pierrejay/sonnette-sip-doorbell/pics/README.md

# pics

Illustrative pictures used by the README and hardware guide.

These files are documentation visuals only. In particular, the enclosure
renders show a 3D-printed prototype, but the enclosure CAD sources are not
published in this repository.
