pierrejay/sonnette-sip-doorbell/docs/README.md

# docs

Project guides and runbooks.

Read them in this order:

1. [twilio.md](twilio.md) — Twilio account, number, SIP Domain and TwiML.
2. [hardware.md](hardware.md) — Linux image, BSP, flashing and hardware notes.
3. [deploy.md](deploy.md) — Build, deploy, harden and verify the application.

The top-level [README](../README.md) gives the short project overview.
