pierrejay/sonnette-sip-doorbell/pics/doorbell_3d_cad_1.png

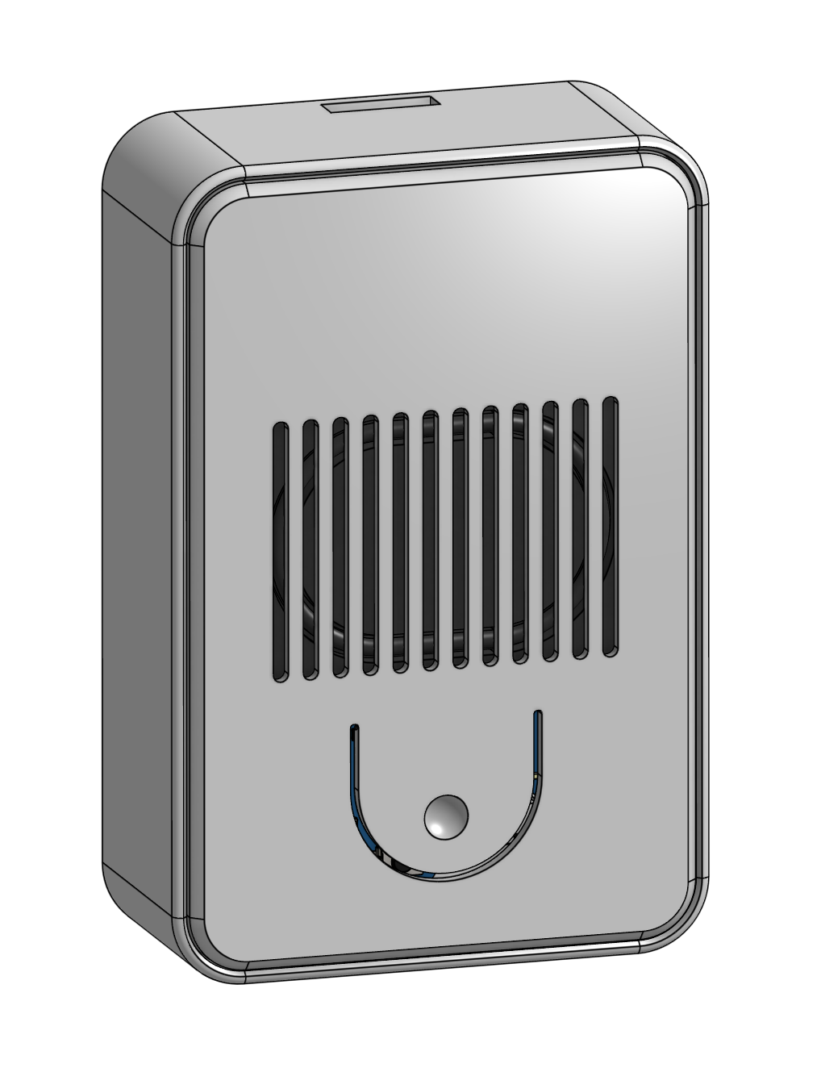
pics/doorbell_3d_cad_1.png
