pierrejay/sonnette-sip-doorbell/eda/sonnette_sch.pdf

# Debug UART

# PMIC (new, replaces discrete bucks below)

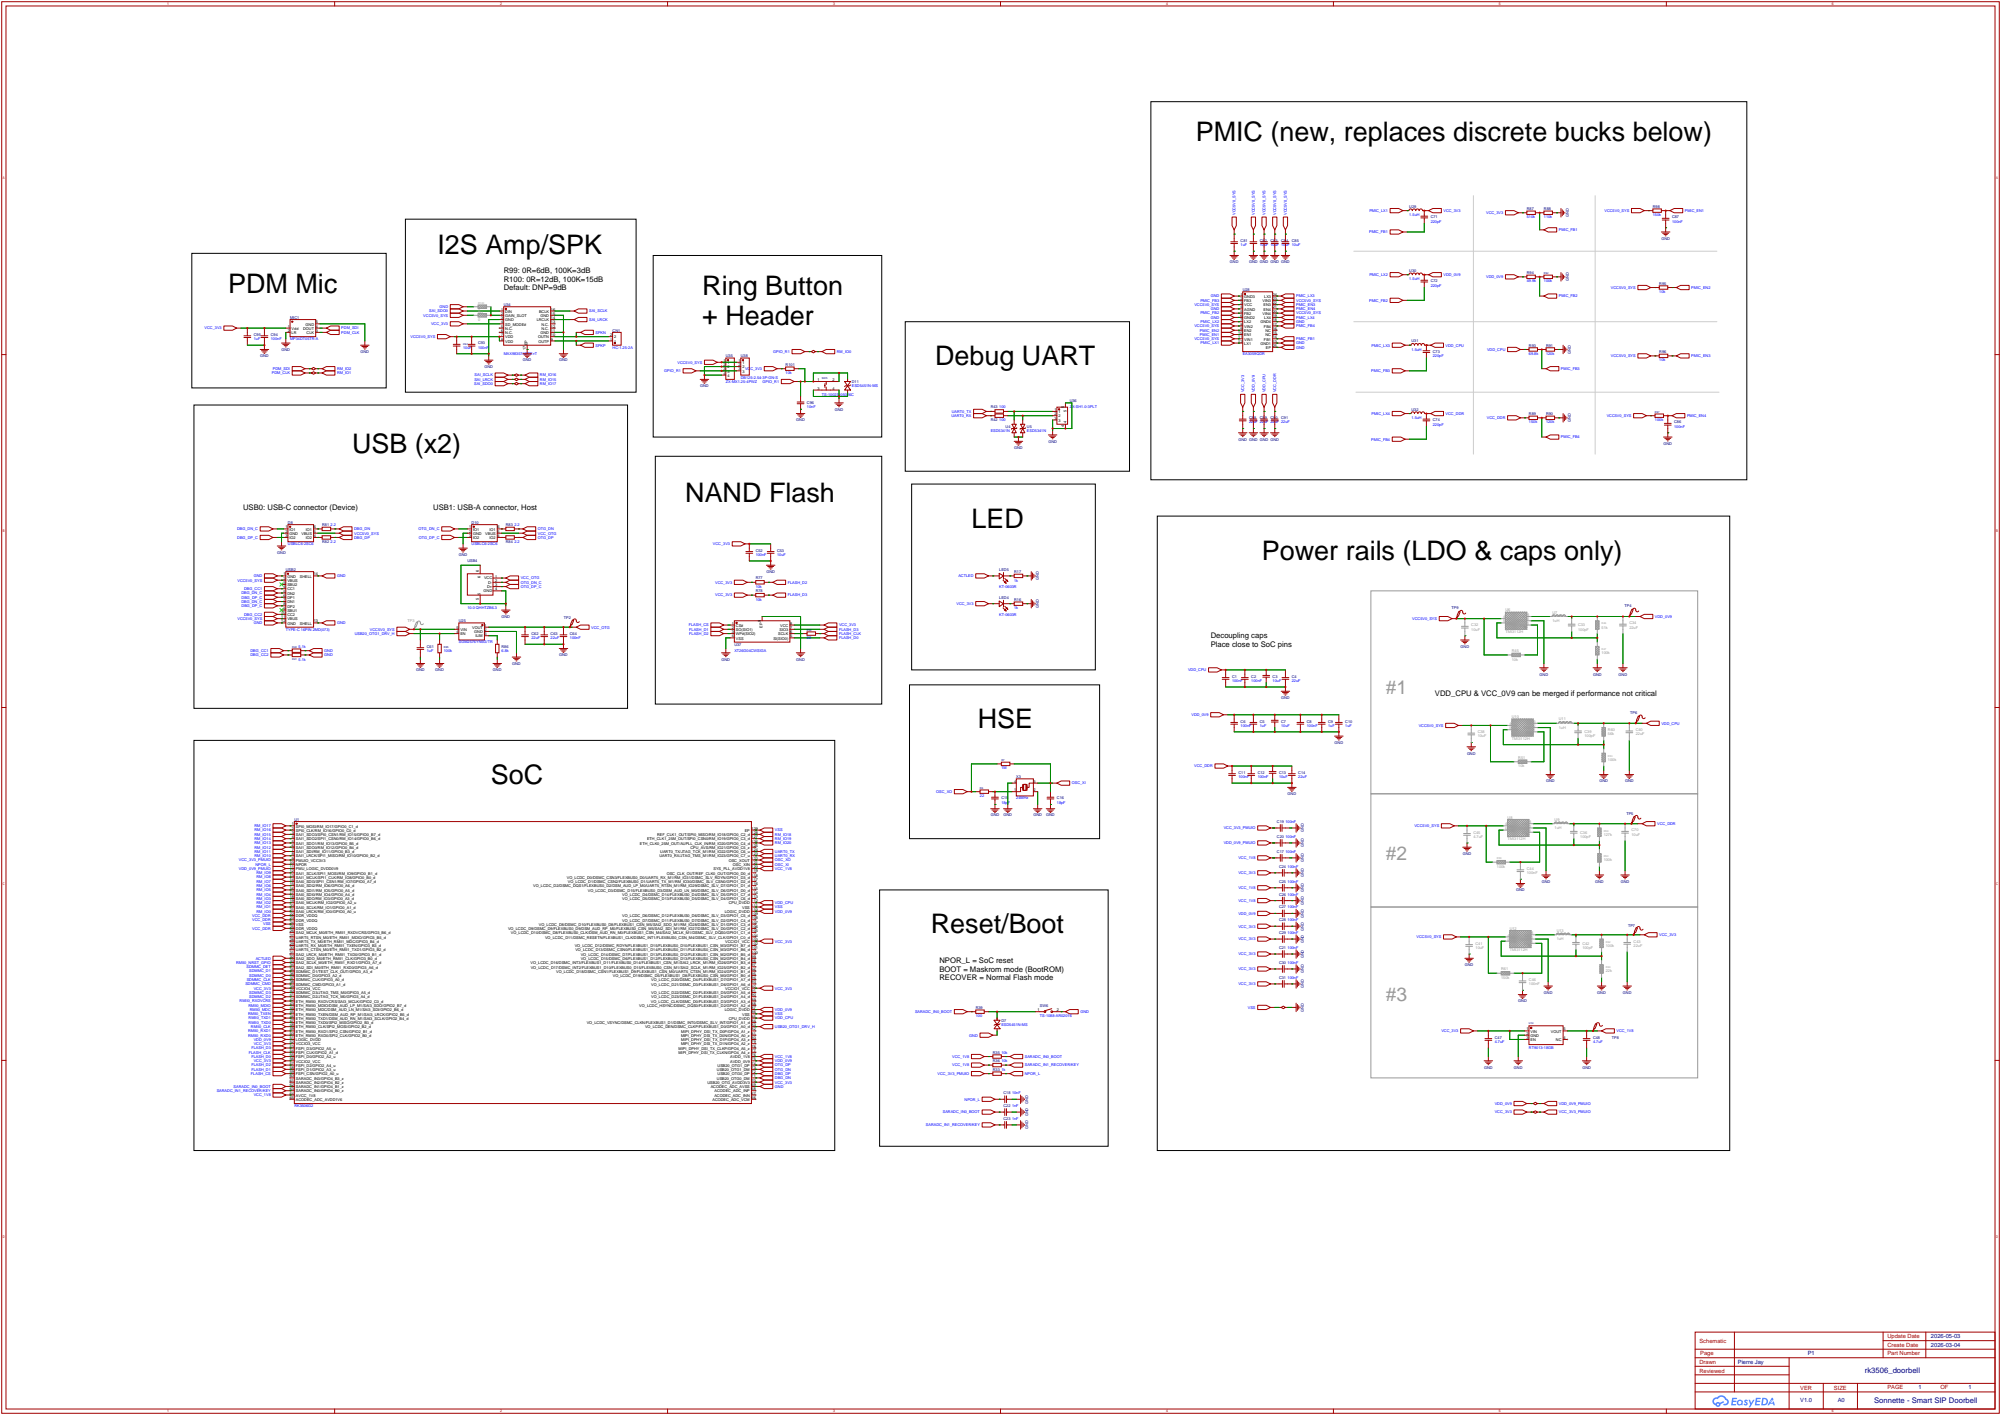
[picture p5: page 1]

GND GND

OUTN 10 GND 11 N.C. 12 N.C. 13 LRCLK 14 GND 15 BCLK 16

Power rails (LDO & caps only)

Decoupling caps
Place close to SoC pins

VDD_CPU & VCC_0V9 can be merged if performance not critical

NPOR_L = SoC reset
BOOT = Maskrom mode (BootROM)
RECOVER = Normal Flash mode
