pierrejay/sonnette-sip-doorbell/(list of files, drawings)

Other design files:
eda/sonnette.epro
