pierrejay/sonnette-sip-doorbell/(commit log)

2026-05-15 Import project
    [sonnette.epro]
2026-05-31 Add interactive BOM
